dainezasc/Remote-voice-control-system/media/complete system front.jpg

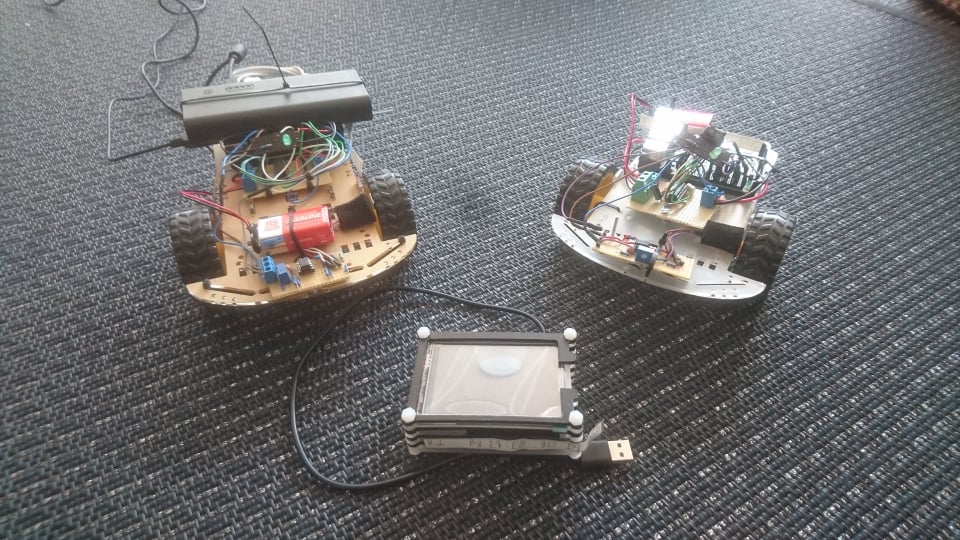
media/complete system front.jpg
