dainezasc/Remote-voice-control-system/media/complete system left side.jpg

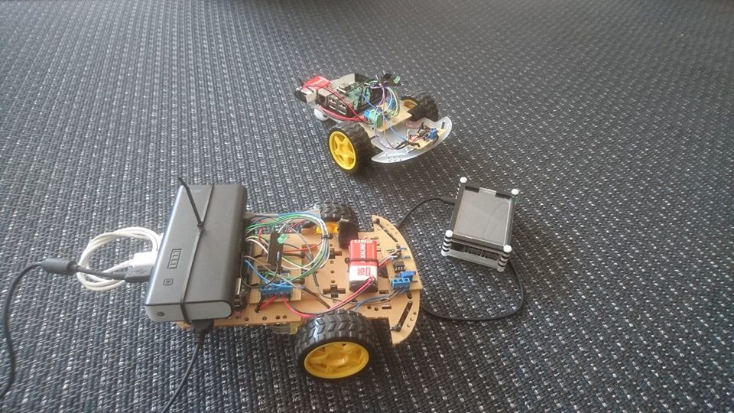
media/complete system left side.jpg
