dainezasc/Remote-voice-control-system/hardware design/hbridgelayout.PNG

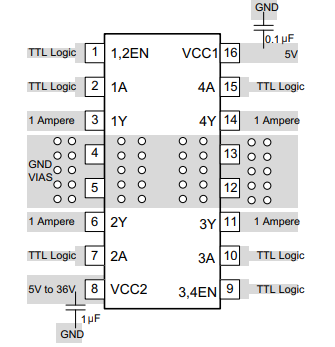
hardware design/hbridgelayout.PNG
