dainezasc/Remote-voice-control-system/hardware design/tek00000.png

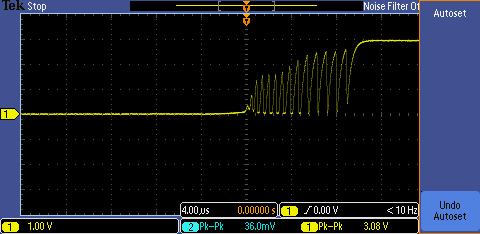
hardware design/tek00000.png
