dainezasc/Remote-voice-control-system/hardware design/tek00002.png

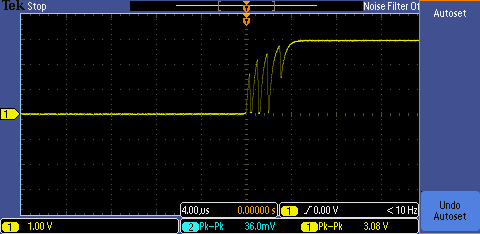
hardware design/tek00002.png
