dainezasc/Remote-voice-control-system/media/complete system right side.jpg

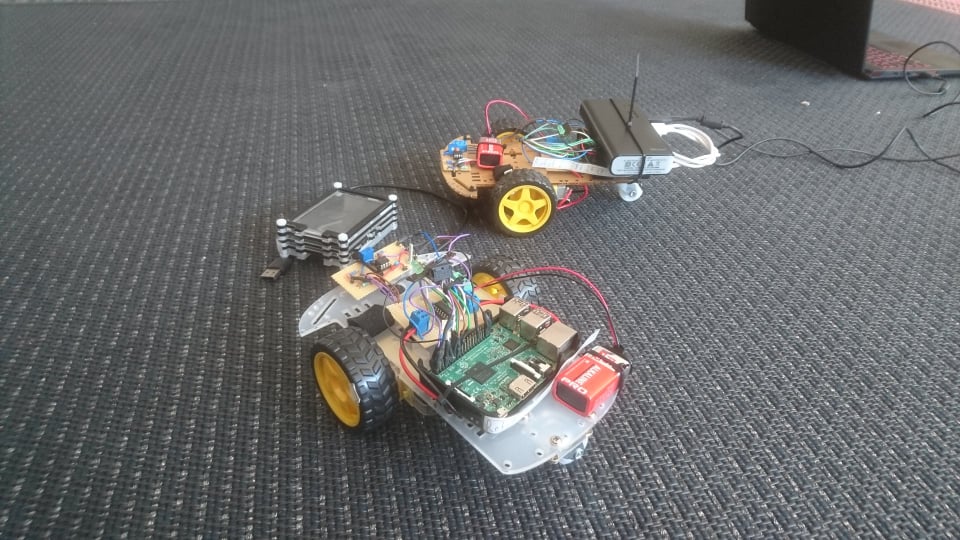
media/complete system right side.jpg
