dainezasc/Remote-voice-control-system/media/complete system with mic headsets.jpg

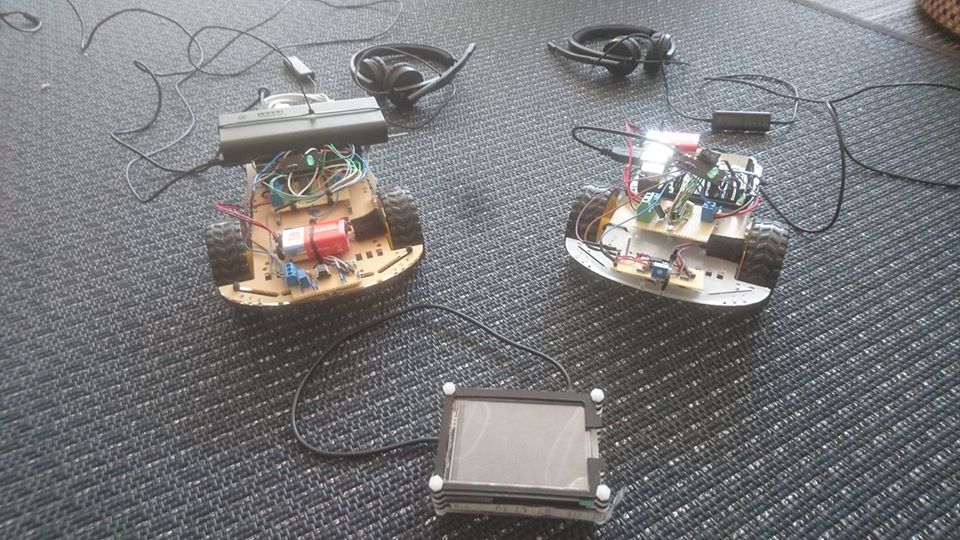
media/complete system with mic headsets.jpg
