dainezasc/Remote-voice-control-system/software design/codefc_hub.PNG

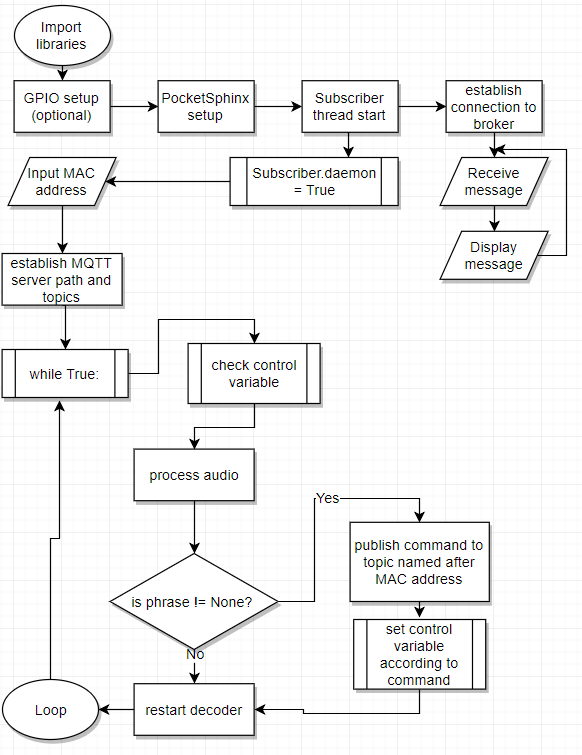
software design/codefc_hub.PNG
