dainezasc/Remote-voice-control-system/(list of files, drawings)

Other design files:
hardware design/PROJECT_DESIGN.DSN
hardware design/Project_design.opj
