dainezasc/Remote-voice-control-system/(commit log)

2018-06-03 Script for hub device
2018-06-03 Script for robot device
2018-06-03 File for enabling ssh on raspberry
2018-06-03 Software design flowcharts
    [codefc_robot.xml]
2018-06-03 Circuit schematics
    [PROJECT_DESIGN.DSN, Project_design.opj]
